ControlSoup/ContraHopper/Software/README.md

# Asoftware
Contains the Flightsoftware used on FlightBread

# Simulation
Basalisk framework simulation files
