ControlSoup/ContraHopper/Documentation/Structures/Motor Mount/Motor Mount.pdf

### 0.0.1 Motor Mount

The first component I decided to start with is interfacing the propeller to the duct. I started by making an assembly with the motors, and inner diameter of the duct floating in free space to get an image of what was required. After this I started thinking about how I could attach these motors. The typical process for me is to start with the most basic shape that meets the physical constraints , and then try and optimize for the failure mode of the part and manufacturability.

### 0.0.1.1 Geometrical Constraints

I started with a flat plate, however the bolt pattern of the motors does not allow the appropriate room for the hardware to be mounted sharing the same plate. This requires a spacer between the two motor mounts, that can allow for clearance of the m3 hex head, as well as integration and tooling (space to put the screw in, and space for an allen key). The length of the M3 screw, is going to be determined by my motor mount adapter thickness. Typically, there are mounted onto carbon fiber or injection molded plastic. For the motors I selected, most drone frames are about 4mm thick. There are some very good guides online on how to design FPV drone frames one is found here. (https://www.youtube.com/watch?v=C_gKnJ7wfto) Assuming an adapter plate of 4mm, I will be choosing a 8mm M3 bolt as my mounting hardware, this leaves 1.5mm sticking out past the motor mount flange. The total height of this bolt is 9.5mm. This gives me the following restrictions:

Distance Between Motor Mounts = M3 Length + 10% = 9.5mm + 10% = 10.45mm Clearance Circle for a M3 head = M3 Head = 5.5mm + 10% = 6.5mm

For the mounting arms, I will be using four cross members that go from the inner diameter of the duct meeting at the center. Three arms was my initial goal, however the bolt pattern did not allow for this. Here is a simplified model, that shows how the part meets each limiting criteria. The thickness of the cross members was kept at the same thickness as the motor mounts. This is to attempt to drive cost of manufacturing down, assuming this is made out of carbon fiber sheet.
Now that I have the most basic geometry for the structure. For analysis I’m going to assume the part is two fixed-fixed beams. For force, I am going to assume a point load based on the thrust of the two motors with zero efficiency loss to be conservative. Here are the results using the simply supported beam function in my Structures Engineering (https://github.com/ControlSoup/StructuresEngineering) repository.

P = Load
L = Length
A = CrossSectionalArea
Vmax = −1.433lbf

Mmax = 3.6722

lbf
in
σbending = 826.59psi

There are other stresses, that take place in this beam. This is not a complete analysis, but I will be stress testing the part to failure to see the true strength.

Images/Motor Mount/Motor Mount.PNG

Figure 1

### 0.0.1.2 Material and Cross Section Optimization

For each material I will iterate through the geometrical constraints, looking for a combinations that have a bending FOS greater than two. After that I will double check the deflection is very low, based on intuition, I want this beam to have a maximum deflection of no more than 0.02in.

Carbon Fiber

The material properties for Carbon fiber are notoriously hard to predict with out doing your own testing. This is made considerably harder by the fact that I don’t think a carbon fiber sheet on its side has the same material proprieties as a sheet in its nominal direction. This is probably negates my results, but I want to see what the hand calculations expect based on some conservative carbon fiber properties. AGATE

Images/simplysupported.png

Figure 2

CARBON PAPER ETD material properties are as follows:

Density = 1.35

g
cm³

= 0.0488

lb
in³
Ultimate Strength = 57.05ksi ElasticModulus = 6.77Msi

The optimization needs to be modified slightly. Carbon fiber sheets come in a select number of thickness, The thickness is what will determine my beam width. The following sizes where available I’ve included all the common options including 4mm found here. (https://protechcomposites.com/resources/standard-thicknesses) Additionally because our material properties are not very well known, and I am using the ultimate strength instead of yield, I will be optimizing to a FOS of 3 on the ultimate strength.

The results where as follows:

Cross Section W idth = 0.254mm Cross Section Height = 10.6mm σmax = 1.834pa

F OSbuckling = 4.5
Deflection = 0.498mm
W eight of Each Beam = 0.473g

Aluminum

Images/Buckling Optimizer_v1.png

Figure 3: Motor Mount Optimization Tree

The properties of aluminum are well know, 7075 T6 has the following properties:

Density = 0.102

lb
in³
Y ield Strength = 83ksi
ElasticModulus = 4.06Msi

The optimization will not need modification, a minimum thickness of 0.25mm was selected arbitrarily. I need a better model of failure to understand width limits.

The optimization results where as follows:

Cross Section W idth = 0.25mm Cross Section Height = 10.45mm σmax = 1.918pa
F OSbuckling = 5.52
Deflection = 0.344mm
W eight of Each Beam = 0.96g

3D Printed PLA

3d printing is a fantastic option for small scale prototyping like I am attempting here. Unfortunately, PLA acts extremely nonlinear under load. Again like carbon fiber, this most likely negates the results of my optimization. However, using some papers that can be found online I can attempt to get an initial guess at the strength of my part for initial design purposes.

The material properties where pulled from Paper1, and paper2 assuming 70% infill and are as follows:

Density = 0.0316

lb
in³
Y ield Strength = 2.5ksi
ElasticModulus = 0.123Msi

The optimization results where as follows:

Cross Section W idth = 1.06mm Cross Section Height = 25mm σmax = 0.079pa
F OSbuckling = 4.65
Deflection = 0.497mm
W eight of Each Beam = 3.033g

### 0.0.1.3 Final Selection and Conceptual Design

Based on these three materials, the optimal choice would be a carbon fiber sheet design. My optimization does not take into a account, torsional buckling, misalignment or the torque applied on the part by the motors when not spinning at the same speed. If I had access to some sort of FEA or analysis software I could be more confident in my design. However my confidence would still not be high due to the uncer-tainty in the material properties available online. I will need to rely on test results to be sure. Fabrication is a slight concern, I would probably go with several laser/CNC cut sheets that fit together using tabs, and then some kind of epoxy to fixture all of these together. This combination is workable, and could be an interesting choice. However, the cost is going to be higher, and making multiple to test to failure is out of my budget for this vehicle.

Aluminum, is an extremely good choice here, the material properties are extremely well known and the part is really not that heavy. Fabrication would be very difficult, this sheet would be extremely thin. Welding is not an option, some sort of epoxy might work but hardware is probably the best option.

PLA is going to be my choice, even though its the worst choice. The material properties are less reliable than carbon fiber, and it creates a substantially heavier piece. However, I am going to be relying on strength testing for all of these, due to my optimization being limited. 3d printing allows me to produce a lot of these parts break them, and modify until I am happy with the part. This also opens up the options of eliminating hardware, which at this scale could save enough weight to break even.

Here is final design, making modifications based on intuition, and rounding optimization results:

Images/mo/Final_Motor_Mount.PNG

Figure 4

The final hand calcs for failure are:

Cross Section W idth = 1.mm Cross Section Height = 25mm σmax = 0.083pa
F OSbuckling = 4.36
Deflection = 0.53mm
W eight of Each Beam = 2.87g

### 0.0.1.4 Testing Results and Changes

Images/Motor Mount/Motor Mount V1.PNG

Figure 5: Initial Print Mass

Initial print, gave me the idea to bring the actual mounting main mount down into the beams, this requires a larger minimum height for the column. Is defiantly strong enough, however deflection of off load axis is high. Suggest thickening sides in case of misalignment or torque. Struts are not available due to the space and print-ability. Notes about expected vs actual I ended up having to use 80% infill material properties have been adjusted also an error in my material properties was found:

ρ = 0.03612lb/∈

3Sy = 3306.86psiE = 203052.8psi

Force distribution if misalignment of thrust is 5◦

T hrust = 2600g
Fy = 2600g ∗ cos 5◦ = 226.6g Fx = 2600g ∗ sin 5◦ = 2590.1g

Based on this, one tenth of the expected thrust should be used as a side load (260g).

Deflection is my primary concern, however because the side load is in reality supported by another beam perpendicular to the one I am analyzing, I am willing to allow three times as much deflection (1.5mm) I will need to see in testing if this will work out.

Images/Motor Mount Optimization_V2png.png

Figure 6: Motor Mount Optimization Tree V2

Results of this optimization are:

Cross Section W idth = 2.638mm Cross Section Height = 18.45mm F OSvertical = 8.223
F OShorizontal = 11.756
Deflectionvertical = 0.303mm Deflectionhorizontal = 1.382 W eight of Each Beam = 6.335g

New Part Model:

Images/Motor Mount/Motor Mount V2.PNG

Figure 7

Test Results
