ControlSoup/ContraHopper/Documentation/Structures/Impact/Impact Investigation.pdf

## 1 Impact Duration

In order to determine an impact duration appropriate for landing, a series of test where preformed to estimate the impact time. Using a drone which is similar in size and mass (960g) to the ContraHopper, dropped from various heights repeatedly, a very rough estimate on two different parameters can be achieved. Its important to note that this is by no means an thorough and definitive answer to this question. The model is vastly over simplifying a complex interaction, results should be used indicate a ballpark including the parking-lot answer.

| Estimated Impact Time
| Validity of rigid body inelastic impact model

The impact model is based on rigid body kinematics, and a inelastic collision.

| Fl = ma
| a = ∆v
| ∆t
| ∆v = vl =

p
2gh
| ∆t =

√
2gh
a
| Fe = m

√
2gh
∆t

(1)

Fl = Landing Force

Fe = Estimated Landing Force

m = Mass of Vehicle

a = Deceleration on impact

∆t = Time of Impact

vl = Landing Velocity

g = Acceleration of Gravity

h = Distance Vehicle Falls

Some of the concerns I have about the results of this test are in the accuracy of the accelerometer measurements as well as the sample rate. Each test was repeated as many times as my neighbors would allow. The IMU being used is a mpu6050, with the following settings:

Log Rate = 200hz

Accelerometer Full scale Range = +-16g

Accelerometer Calibration Method = Post-Logging Mean Offset

Additionally, I am dropping the drone from marking on a tape measure by eye, there is likely an error in the height measurement.

## 2 Results


## 3 Notes

Unfortunately, this shows data that with the current configuration I will be unable to measure impact time, or loads. This does indicate that I should expect at least 4gs, more than that is unkown.

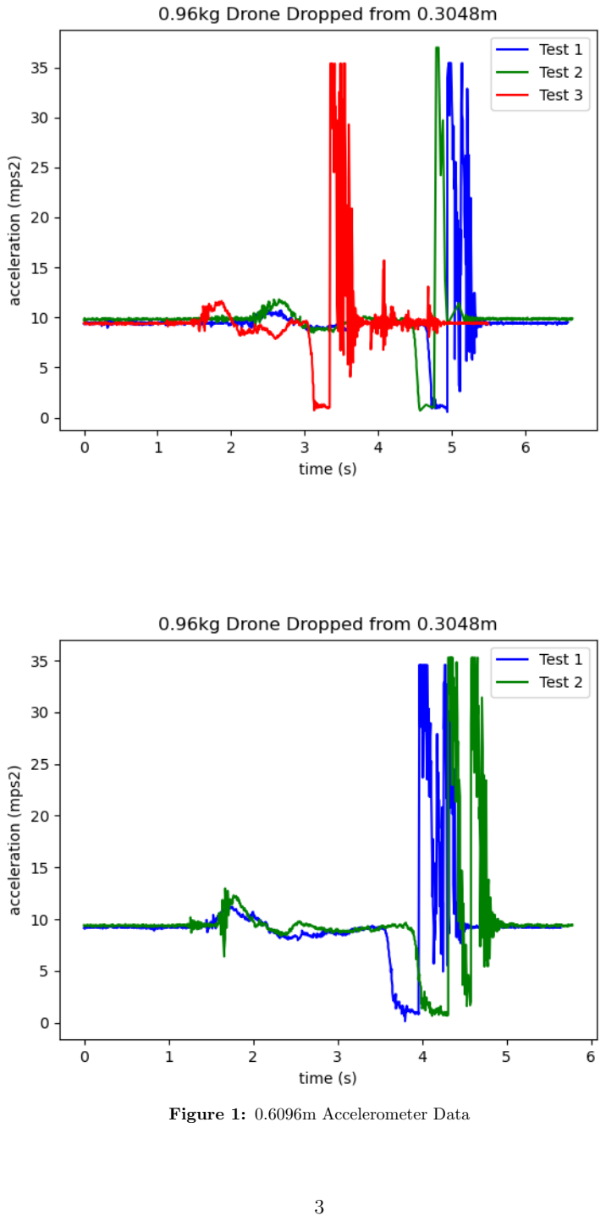
[picture p9: page 3]

Figure 1: 0.6096m Accelerometer Data
