ControlSoup/ContraHopper/Documentation/Structures/Landing Legs/Landing_Legs.pdf

### 0.0.1 Landing Gear

There are a couple different types of landing gear typically used on landers, shown bellow.


Based on research (Paper 1 (https://books.google.com/books?id=Pe4lEAAAQBAJ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) , Paper 2) (https://ltu.diva-portal.org/smash/get/diva2:1159285/FULLTEXT01.pdf) the tripod design offers the best specific strength and simpler analysis for small landers. This makes logical sense, as it is essentially just a truss. For this design no damping will be used.

The first question that needs answering to eventually get to the exact geometry of the landing gear, is how big does my landing radius need to be? The landing radius as I am defining it, is based on the circle that intersects each foot of the landing gear. The minimum effective tip-over radius is defined by the number of legs in this given landing radius. The more legs that are added, the closer the minimum effective tip-over radius comes to the landing radius. This is important in calculating your worst case tip over. The worst case tip over will exist about the axis defined by a line between any two neighboring legs around the

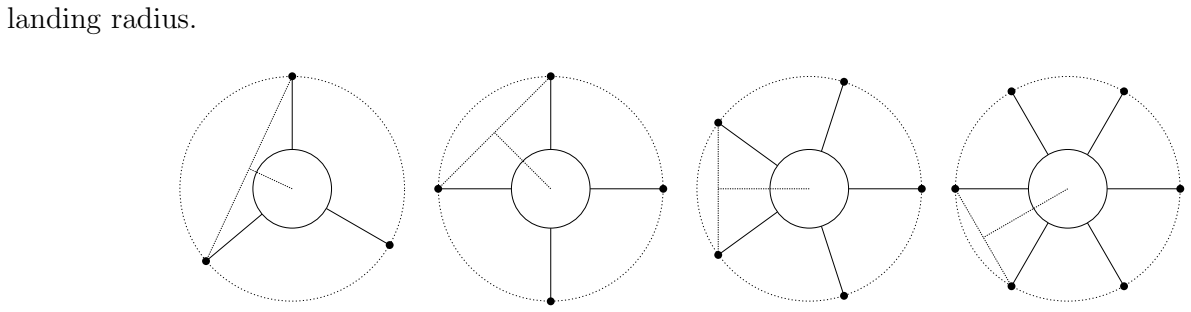
[picture p10: figure]
landing radius.

Four legs was chosen for this vehicle, due to motor mounts geometric constraints. This allows the landing legs to stay integrated, symmetric and a consistent with the rest of the vehicle frame.

Because landing is a complicated dynamic problem, I will be simplifying by choosing a large static tip over angle in the hopes that this results in a large enough effective landing radius, to compensate for the complex behavior. In order to design more carefully, I would need to estimate potential side forces, kinetic friction of the landing surface and run rigid body simulations to accurately access dynamic tip over. Instead , I have chosen a static tip over angle of 50◦
from horizontal. Because my landing gear is both symmetrical and square, I can also represent this in 2D without projecting a effective landing radius (this is not the case for different amounts of legs). This means that the minimum effective landing width (lw), must not exceed the value calculated value in Equation(1).

θ = Tip Over Angle

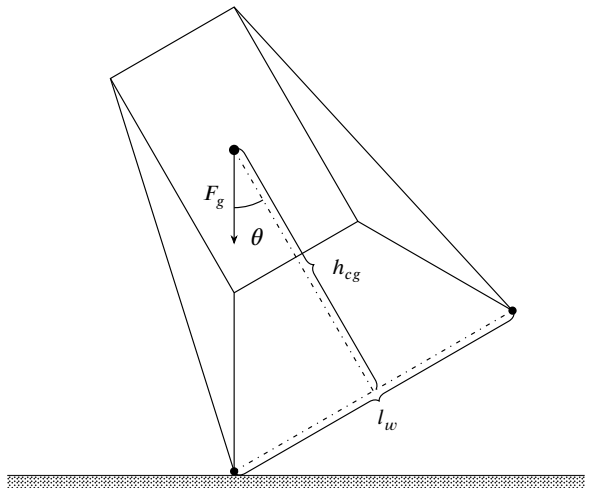
[picture p11: figure]
ℎcg

hcg = Height of the Center of Gravity

lw = Effective Landing Width

Fg = Force of Gravity

lw = 2hcg sin θ | (1)

The height of the center of gravity with respect to the landing gear, is equal to the current height of the structure of the vehicle, plus a chosen two and a half inches of ground clearance. After the major mass components had finished design, this height came out to 8.947in.

lw = 2 ∗ 8.947in ∗ sin 50◦

lw = 13.7in

From this, using the derived sketch of the vehicle, the ground clearance and effective landing radius can be defined to generate the base coordinates of the landing gear truss members.

Estimated landing forces, as I have found is extremely difficult without building something, simulating something or using expensive analysis software. Originally, I was going to use a hand calculation based on the assumption of a inelastic collision with the ground. Unfortunately, this requires a major assumption about the time duration of the impact. Resources online vary wildly for how long an impact takes to decelerate a body, a difference of a couple milliseconds can vary the load by a factor of more than 100. I attempted to measure impact accelerations and estimate this time, using a drone dropped from various heights however the mems accelerometer that I am using even at its max full scale range of +-16gs, provided saturated and untrustworthy data of around 4gs. For this reason I will be adding a conservative fudge factor of 2 onto that measure figure (8gs). This is not accurate is simply a judgment call, for the purposes of future vehicle designs. I will be building a dedicated test stand to measure impact loads on landing. I will adjust the landing leg design once I have a better idea what these loads are.

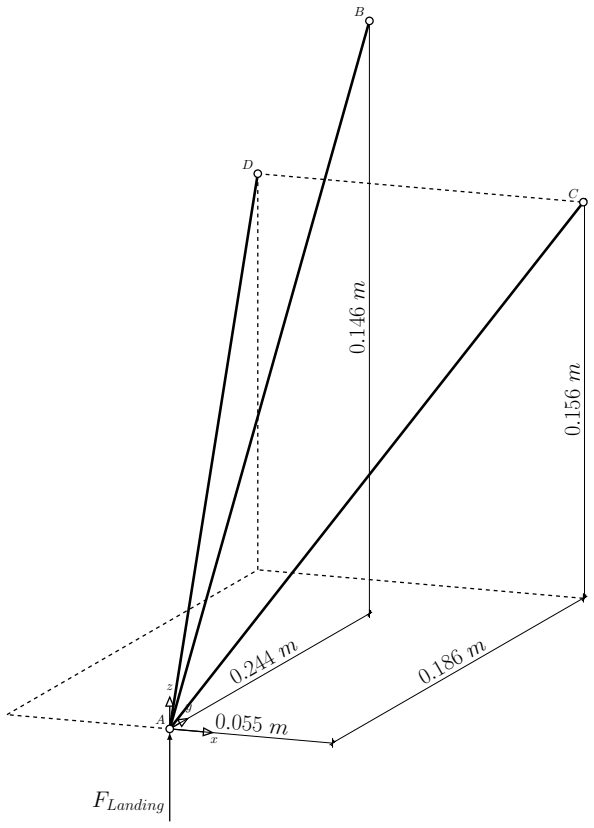
[picture p12: figure]
FLanding

Figure 1: Landing Leg Truss

Using the current estimated mass of the vehicle without landing legs (an assumption that needs to be considered for the FOS later, landing gear may increase the vehicle mass by 10%) of 591.58g, the following landing load on the vehicle was calculated:

Fl = 8g mv = 8 ∗ 9.8055

m
s

2

∗ 0.59158kg = 46.4N

Now that the landing load is known, the problem is statically determinate and requires only analysis at the foot joint.

A

Fl
4

Fc

Ft1

Ft2

Vector Components:

Fl
4

[0i + 0j + 1k]

Fc [0i + 0.51282263j + 0.85849458k]

Ft1

[0.22127908i + 0.74661525j + 0.62737647k]

Ft2 = F2 [-0.2212790i + 0.74661525j + 0.62737647k]

Assuming all members are in tension (despite the intuition shown in the FBD) the following static equations can be derived:

ΣFi = Ft1

i − Ft1

i = 0
ΣFj = Fcj + 2 Ft1

j = 0

ΣFk =

Fl
4

k + Fck + 2Ft1 k = 0

(2)

Supplementing the design figure of landing force and simplifying:

Fl
4

k = 11.6N

0.512 Fc + 1.493 Ft1 | = 0
0.858 Fc + 1.254 Ft1 | = −11.6N

Solving the system of equations:

Fc = −27.15N
Ft1 = Ft2 = 9.32N

Negative values indicate the member is in compression. Its important to note at this point that the actual assembly is not the ideal truss, there are slight eccentric loads and the members will not be in perfect axial loading conditions as assumed in this model. For this reason I will be using higher FOS than usual. Additionally, the initial results of this optimization showed cross sections that where very small in the tension. This small cross section made me concerned about deflection, this has been added to the optimization. Deflection was not a consideration for the compression members.

Now that the loads have been established, an optimization for the minimum weight member given a cir-cular cross section can be preformed based on the following design factors.

Compression Member:

Failure Mode = Buckling

Target Factor of Safety on Ultimate = 4

Tension Members:

Failure Mode = Tensile

Target Factor of Safety on Ultimate = 2.5

Target Displacement = 0.0025m

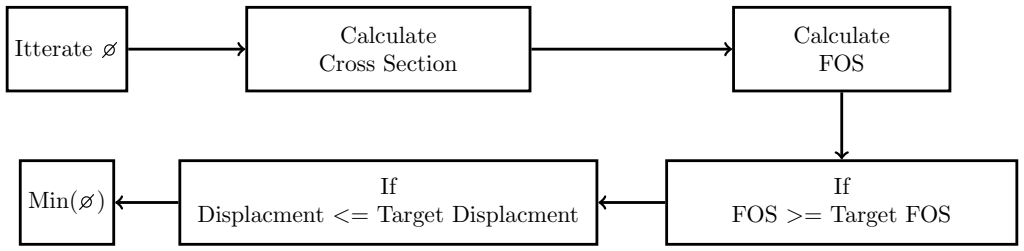
[picture p13: figure]
Itterate ; Calculate Cross Section; Calculate FOS; If FOS >= Target FOS

Displacment <= Target Displacment Min()

The material trade was not in depth for this part, carbon fiber seemed to be the logical choice for both integration and mass.

Results:

Compression Member:

Diameter = 0.003358m

Factor of Safety = 4

Tension Members:

Diameter = 0.00029m

Factor of Safety = 11.3

Displacement = 0.0025m

Based on the available carbon rods the final size choice is:

Compression Member Diameter = 3.45mm (0.136in)

Tension Member’s Diameter = 0.5mm (0.020in)


Design as of 09/10/22
