ControlSoup/ContraHopper/Documentation/Structures/Landing Legs/Landing_Legs_Fig/FBD_point_A.pdf

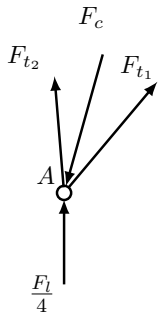
[picture p14: figure]
