ControlSoup/ContraHopper/Documentation/Structures/Landing Legs/Landing_Legs_Fig/Landing_Leg_Optimization_Logic.pdf

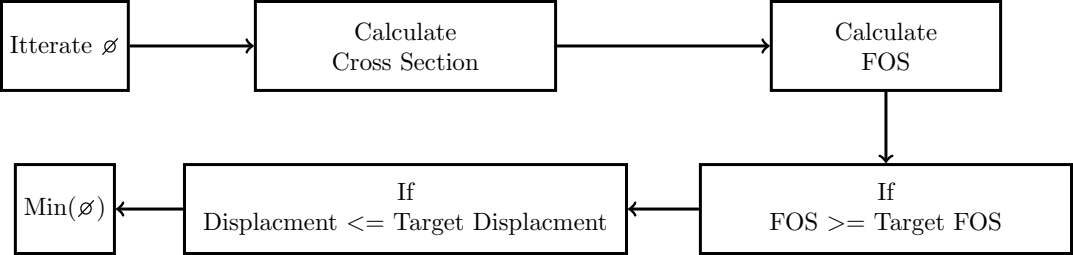
[picture p15: figure]
Itterate ; Calculate Cross Section; Calculate FOS; If FOS >= Target FOS

Displacment <= Target Displacment Min()
