ControlSoup/ContraHopper/Documentation/Structures/Landing Legs/Landing_Legs_Fig/Landing_Radius.pdf

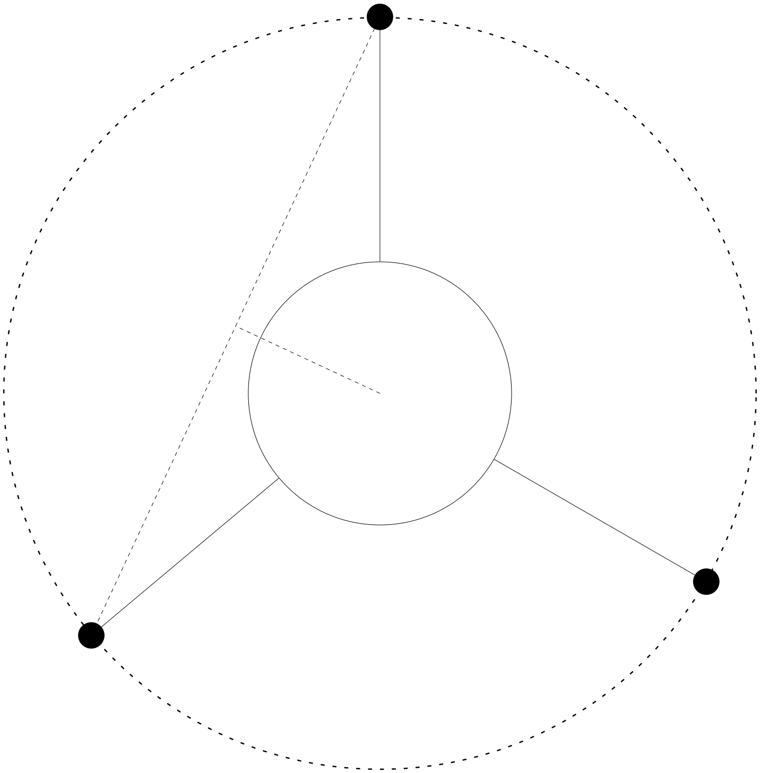
[picture p16: figure]
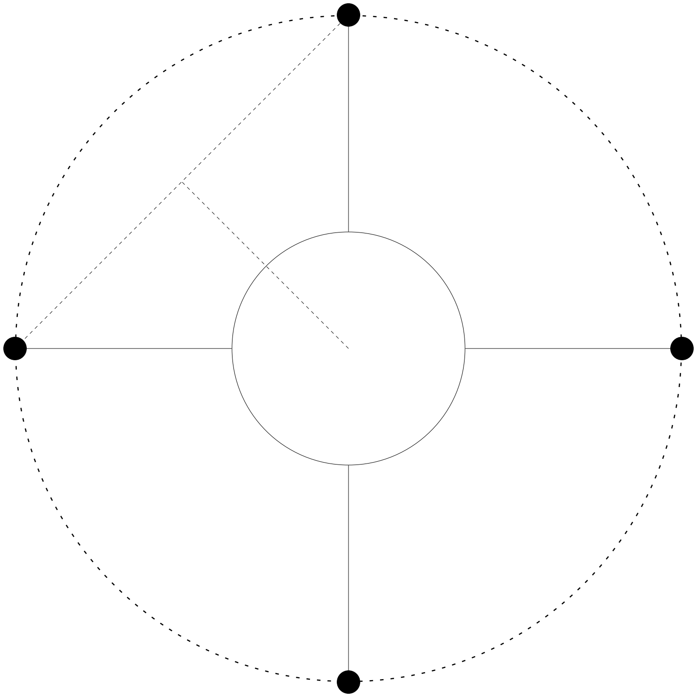
[picture p17: figure]
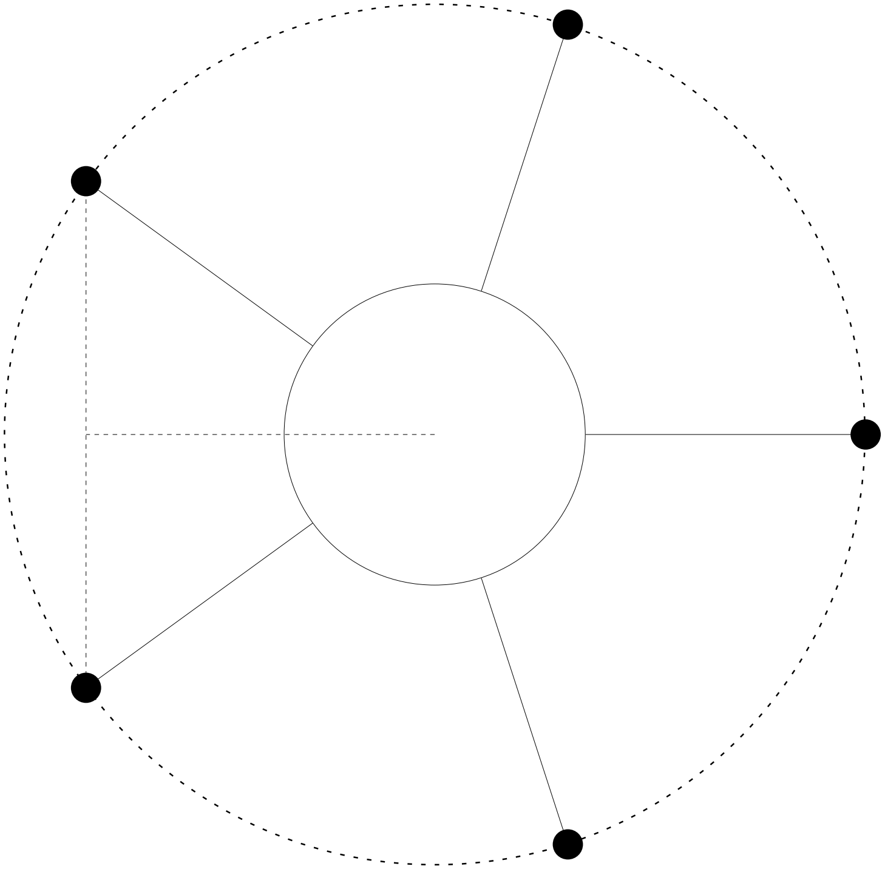
[picture p18: figure]
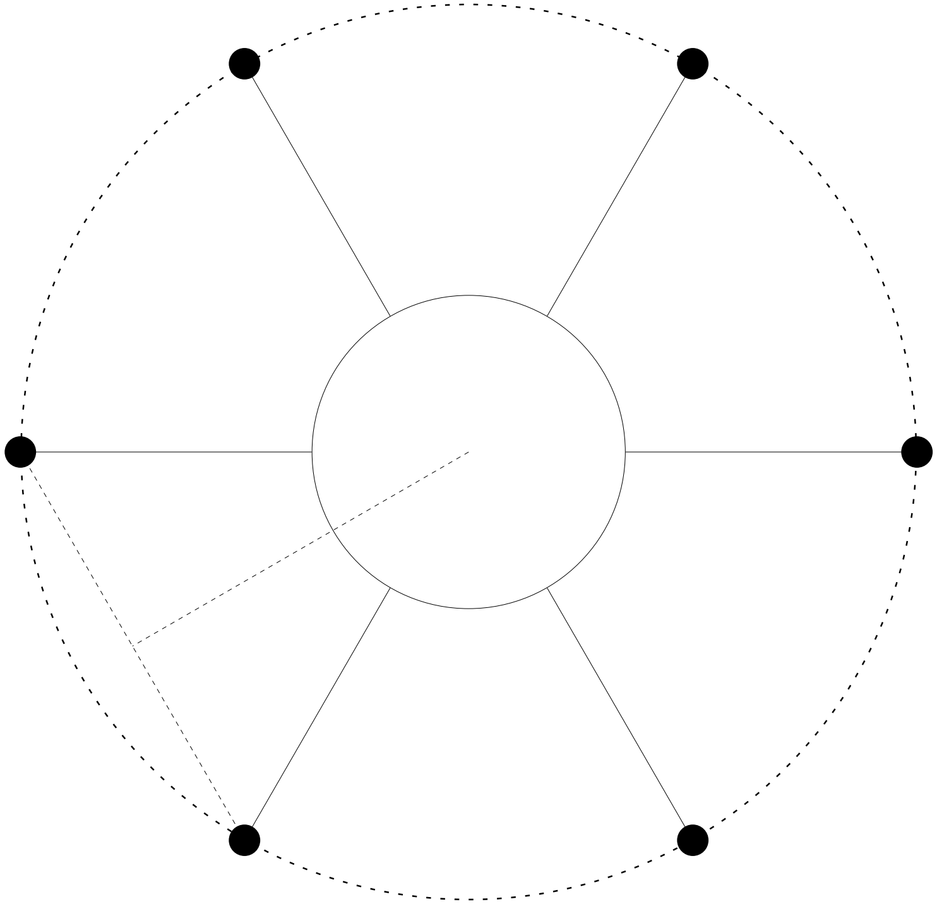
[picture p19: figure]
