ControlSoup/ContraHopper/Documentation/Structures/Landing Legs/Landing_Legs_Fig/Tip_Over.pdf

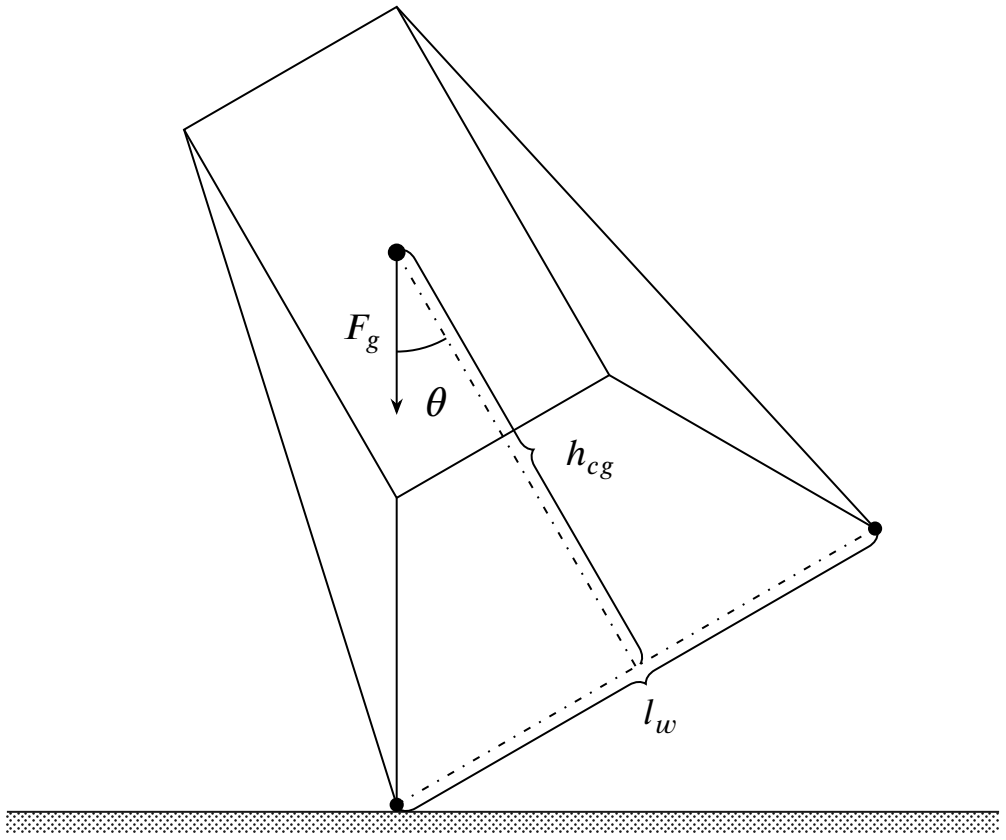
[picture p20: figure]
ℎcg
