ControlSoup/ContraHopper/Documentation/Structures/Vehicle Frame/Vehicle_Frame_Fig/Deriving Sketch 2.PNG

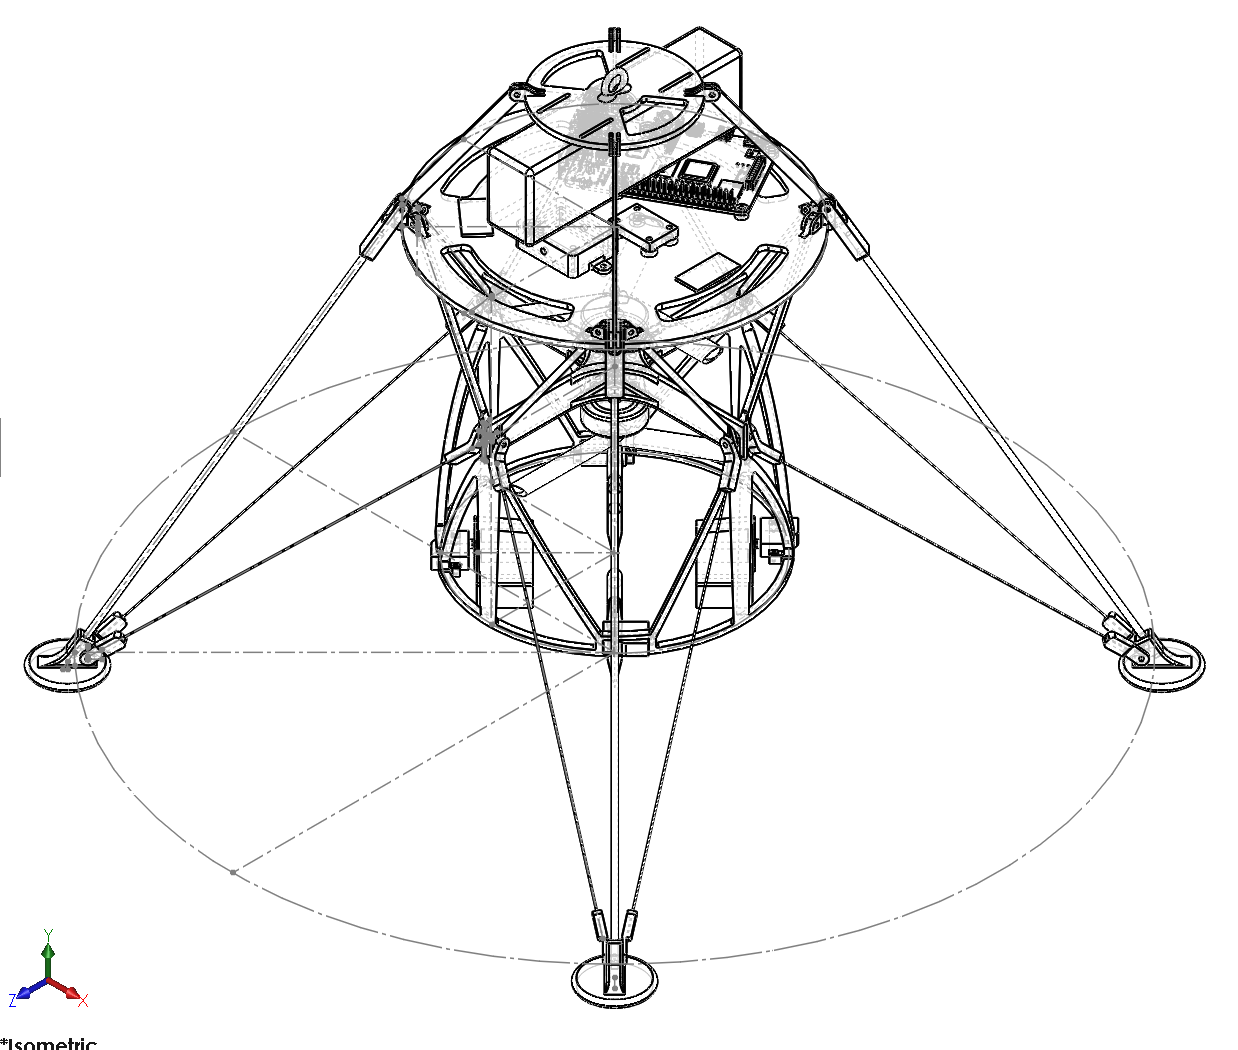
Documentation/Structures/Vehicle Frame/Vehicle_Frame_Fig/Deriving Sketch 2.PNG
