ControlSoup/ContraHopper/Documentation/Structures/Vehicle Frame/Vehicle_Frame_Fig/Deriving Sketch.PNG

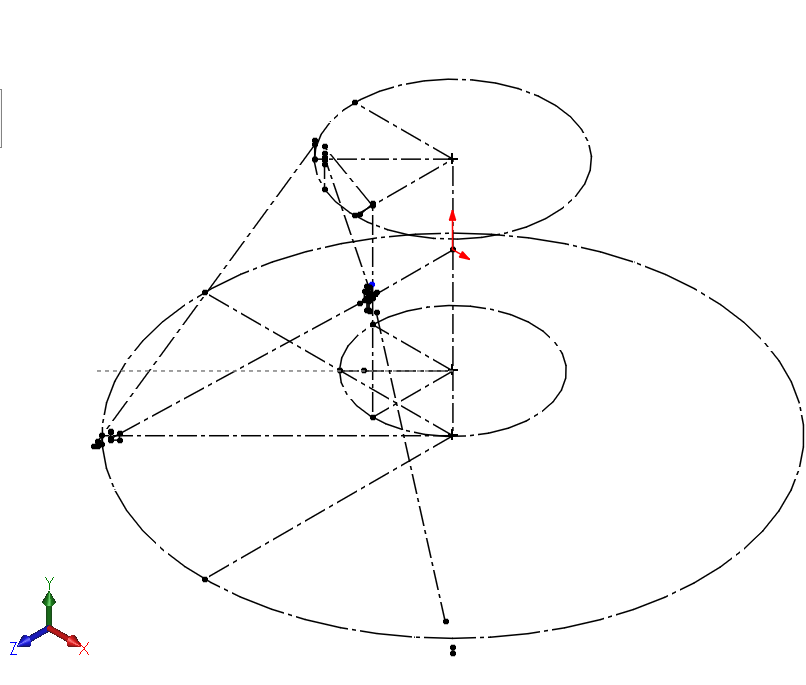
Documentation/Structures/Vehicle Frame/Vehicle_Frame_Fig/Deriving Sketch.PNG
