ControlSoup/ContraHopper/Avionics/PCB/FlightBread_0.1.step

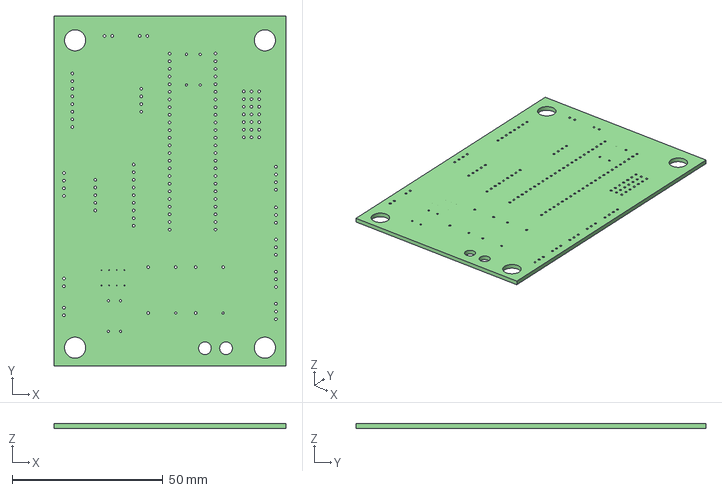
[picture p23: CAD file, 2023-03-12]
Avionics/PCB/FlightBread_0.1.step
77.0 x 116.0 x 1.60 mm
