ControlSoup/ContraHopper/Tests/Impact Test/1ft_test_1.txt

test_number,time(s),ax(ms2),ay(ms2),az(ms2),gx(deg/s),gy(deg/s),gz(deg/s)
1,0.01,1.35,-0.35,8.87,0.01,-0.23,-0.19
1,0.02,1.39,-0.34,8.94,-0.09,-0.09,-0.02
1,0.02,1.33,-0.33,8.95,0.13,-0.08,-0.02
1,0.03,1.3,-0.34,8.9,-0.05,0.05,-0.16
1,0.03,1.33,-0.35,8.97,-0.06,0.09,0.05
1,0.04,1.22,-0.36,8.84,-0.09,0.12,0.02
1,0.04,1.29,-0.32,8.96,-0.16,0.08,-0.07
1,0.04,1.31,-0.32,9,0,-0.15,-0.15
1,0.05,1.33,-0.36,9,0.03,0.15,-0.12
1,0.06,1.25,-0.34,8.88,-0.02,0,-0.16
1,0.06,1.38,-0.32,9.02,0.06,-0.02,-0.04
1,0.06,1.28,-0.37,8.94,-0.05,0,-0.3
1,0.07,1.4,-0.32,8.92,0.07,-0.29,-0.19
1,0.08,1.25,-0.35,8.92,-0.02,-0.03,-0.04
1,0.08,1.37,-0.3,8.93,0.12,0,-0.27
1,0.08,1.22,-0.35,8.98,0.17,0.02,-0.24
1,0.09,1.38,-0.27,8.87,-0.09,-0.02,0
1,0.1,1.25,-0.3,8.85,0.1,-0.11,-0.13
1,0.1,1.39,-0.38,8.93,-0.02,0.09,0.05
1,0.1,1.23,-0.35,9.01,0.04,0.09,-0.12
1,0.11,1.36,-0.26,8.95,0.01,-0.02,-0.33
1,0.12,1.22,-0.44,8.85,-0.06,-0.02,-0.15
1,0.12,1.32,-0.29,8.98,0.03,0.11,0
1,0.12,1.28,-0.36,8.9,-0.03,0,-0.24
1,0.13,1.26,-0.3,8.92,0.1,0.05,-0.19
1,0.14,1.33,-0.28,8.89,0.03,0.09,-0.13
1,0.14,1.29,-0.36,8.83,0.04,-0.06,-0.15
1,0.15,1.38,-0.32,8.89,0.07,-0.17,-0.24
1,0.15,1.27,-0.34,8.91,0.04,0,-0.34
1,0.16,1.28,-0.32,8.95,-0.06,-0.2,-0.13
1,0.16,1.4,-0.3,9.02,-0.23,0.18,-0.18
1,0.17,1.25,-0.34,8.91,-0.03,0.09,0
1,0.17,1.39,-0.34,9.01,-0.06,0.08,-0.08
1,0.17,1.21,-0.32,8.97,-0.22,0.03,-0.13
1,0.18,1.4,-0.33,8.98,0.07,0,0
1,0.19,1.32,-0.3,8.88,-0.14,0.05,-0.19
1,0.19,1.32,-0.32,8.89,0.07,0.06,0.04
1,0.19,1.26,-0.38,8.95,0.12,0.02,-0.05
1,0.2,1.33,-0.32,8.97,-0.03,0.08,0.05
1,0.2,1.32,-0.34,8.96,0.07,-0.06,-0.05
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
