ControlSoup/ContraHopper/Tests/Impact Test/1ft_test_3.txt

test_number,time(s),ax(ms2),ay(ms2),az(ms2),gx(deg/s),gy(deg/s),gz(deg/s)
3,35.57,1.25,-0.26,8.97,0.04,0.03,-0.05
3,35.58,1.36,-0.28,8.88,0.03,-0.13,0.06
3,35.58,1.23,-0.28,8.85,-0.06,0.09,0.11
3,35.59,1.36,-0.29,8.97,-0.08,-0.1,-0.05
3,35.59,1.31,-0.29,8.91,-0.17,-0.06,-0.09
3,35.6,1.23,-0.35,9.06,0.06,0.09,0.14
3,35.6,1.39,-0.33,8.88,0.14,-0.05,0.14
3,35.61,1.28,-0.32,8.91,0.01,-0.1,0.17
3,35.61,1.38,-0.32,8.88,0.01,-0.05,-0.08
3,35.62,1.24,-0.36,8.9,0.15,0.07,-0.05
3,35.62,1.36,-0.3,8.92,-0.08,-0.14,0.06
3,35.63,1.3,-0.28,8.93,0.01,0,-0.06
3,35.63,1.32,-0.3,8.84,-0.08,-0.23,0.14
3,35.64,1.25,-0.28,8.9,0.01,-0.14,0.08
3,35.65,1.35,-0.29,8.92,0.03,0.03,0.06
3,35.65,1.34,-0.37,8.83,0.15,-0.03,-0.03
3,35.65,1.29,-0.29,8.87,0.03,0.07,-0.05
3,35.66,1.37,-0.33,8.94,0.14,-0.06,-0.14
3,35.67,1.31,-0.31,8.99,-0.08,-0.05,-0.05
3,35.67,1.26,-0.29,8.88,-0.18,0.03,0.14
3,35.68,1.31,-0.31,8.87,0,-0.03,0.08
3,35.68,1.33,-0.33,8.85,-0.03,0.26,0.27
3,35.69,1.28,-0.37,8.91,0.01,-0.03,0
3,35.69,1.32,-0.32,8.86,0.12,-0.16,-0.08
3,35.7,1.36,-0.32,8.95,-0.11,0.1,0.01
3,35.7,1.26,-0.32,8.94,-0.18,0.04,0
3,35.71,1.35,-0.36,8.87,-0.08,-0.17,0.06
3,35.71,1.3,-0.27,8.99,0.21,0.01,0.05
3,35.72,1.39,-0.33,8.89,-0.05,-0.11,0.06
3,35.72,1.32,-0.29,8.85,-0.17,-0.13,-0.06
3,35.73,1.29,-0.38,8.95,-0.09,0,-0.08
3,35.73,1.35,-0.31,8.9,-0.06,0.04,0.03
3,35.74,1.32,-0.34,8.87,0.27,0.03,0.05
3,35.74,1.39,-0.29,8.95,-0.12,0.01,-0.02
3,35.75,1.22,-0.39,8.95,-0.08,0.16,-0.08
3,35.75,1.39,-0.29,8.9,0.03,-0.2,-0.06
3,35.76,1.32,-0.35,8.92,-0.22,-0.16,-0.06
3,35.76,1.39,-0.33,8.88,0.12,-0.13,-0.03
3,35.77,1.25,-0.33,8.87,0.14,-0.11,0.01
3,35.77,1.33,-0.26,8.95,0,0.1,0.03
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
