ControlSoup/ContraHopper/Tests/Impact Test/2ft_test_1.txt

test_number,time(s),ax(ms2),ay(ms2),az(ms2),gx(deg/s),gy(deg/s),gz(deg/s)
1,0.01,1.19,-0.34,8.89,0.02,0.05,-0.03
1,0.02,1.41,-0.34,8.8,-0.01,0,0.06
1,0.02,1.25,-0.4,8.87,0.14,-0.15,-0.03
1,0.03,1.39,-0.31,8.89,-0.08,-0.1,-0.07
1,0.03,1.27,-0.34,8.94,0.09,-0.07,-0.13
1,0.04,1.43,-0.31,8.95,0.18,0.13,-0.16
1,0.04,1.29,-0.35,8.95,0.03,-0.13,-0.16
1,0.05,1.36,-0.33,8.87,-0.01,-0.04,0.02
1,0.05,1.28,-0.33,8.91,0.15,-0.13,0.06
1,0.06,1.36,-0.37,9,-0.01,-0.07,-0.13
1,0.06,1.31,-0.37,8.9,-0.01,0,-0.13
1,0.07,1.35,-0.35,8.92,0.15,-0.04,-0.01
1,0.07,1.25,-0.37,8.93,0.05,-0.25,-0.1
1,0.08,1.3,-0.37,8.89,-0.12,-0.05,0.06
1,0.08,1.3,-0.36,9.02,0.23,-0.1,0.08
1,0.09,1.35,-0.33,8.98,-0.05,-0.02,0.05
1,0.09,1.26,-0.37,8.97,0.02,-0.19,-0.12
1,0.1,1.3,-0.36,8.95,-0.03,-0.15,-0.03
1,0.1,1.3,-0.34,8.96,0.12,-0.05,-0.04
1,0.11,1.27,-0.42,8.92,0.09,-0.13,-0.04
1,0.11,1.33,-0.37,9.04,-0.03,-0.11,0.08
1,0.12,1.28,-0.36,8.97,0.03,-0.08,0.03
1,0.12,1.3,-0.29,9.03,-0.09,-0.22,-0.13
1,0.13,1.23,-0.32,8.94,-0.11,0,-0.06
1,0.13,1.33,-0.33,8.91,0.06,-0.07,-0.03
1,0.14,1.33,-0.35,8.94,0.02,-0.11,-0.06
1,0.14,1.35,-0.3,9,0.12,-0.18,-0.03
1,0.15,1.32,-0.35,9,-0.08,-0.1,0.09
1,0.16,1.38,-0.27,8.94,0.02,-0.05,0.02
1,0.16,1.21,-0.38,8.92,0.06,-0.08,0.03
1,0.17,1.39,-0.3,8.91,-0.01,0,-0.15
1,0.17,1.29,-0.36,8.9,-0.14,-0.21,-0.03
1,0.17,1.37,-0.34,8.95,0.02,-0.07,0.05
1,0.18,1.27,-0.35,8.95,-0.01,-0.18,0.09
1,0.19,1.3,-0.35,8.95,0,-0.21,-0.03
1,0.19,1.27,-0.35,8.94,0.11,-0.07,0.09
1,0.19,1.43,-0.39,9,-0.06,-0.16,0.05
1,0.2,1.24,-0.36,8.87,-0.12,0,-0.09
1,0.2,1.33,-0.34,8.97,-0.01,0,-0.07
1,0.21,1.29,-0.37,8.9,-0.11,-0.08,0.08
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
