ControlSoup/ContraHopper/Documentation/Structures/Landing Legs/Landing_Legs_Fig/Landing_Leg_Truss.pdf

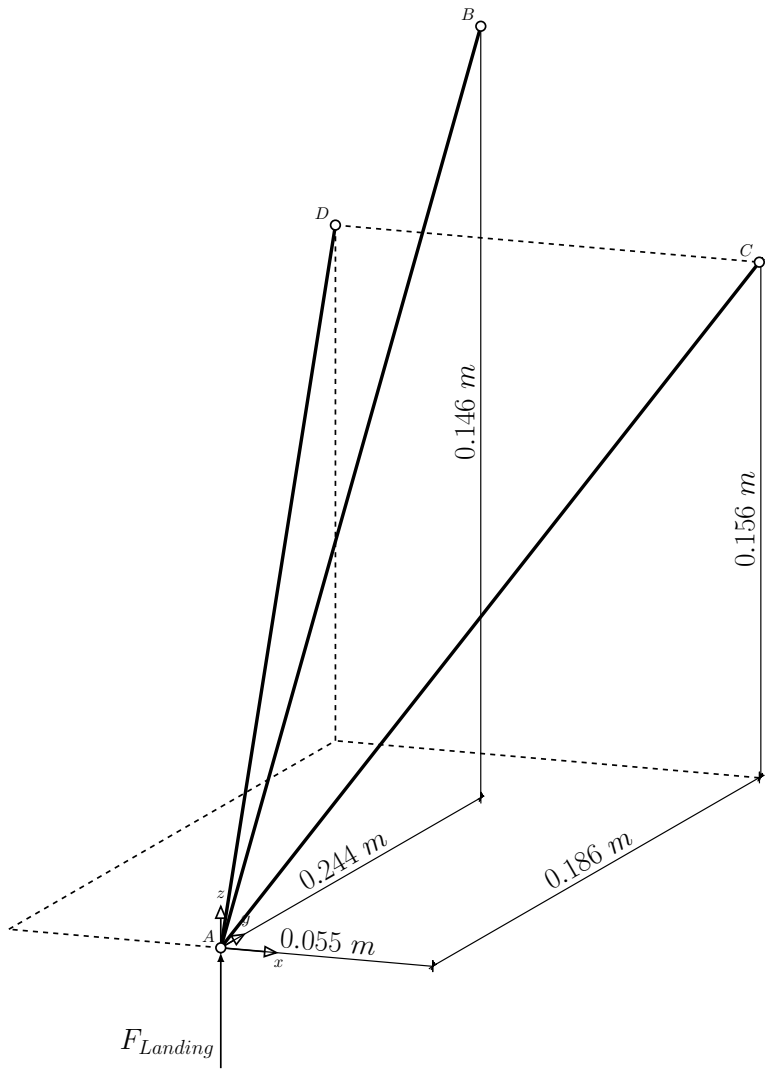
[picture p24: page 1]
FLanding
