ControlSoup/ContraHopper/Documentation/Structures/Vehicle Frame/Vehicle_Frame_Fig/Tether_Truss.pdf

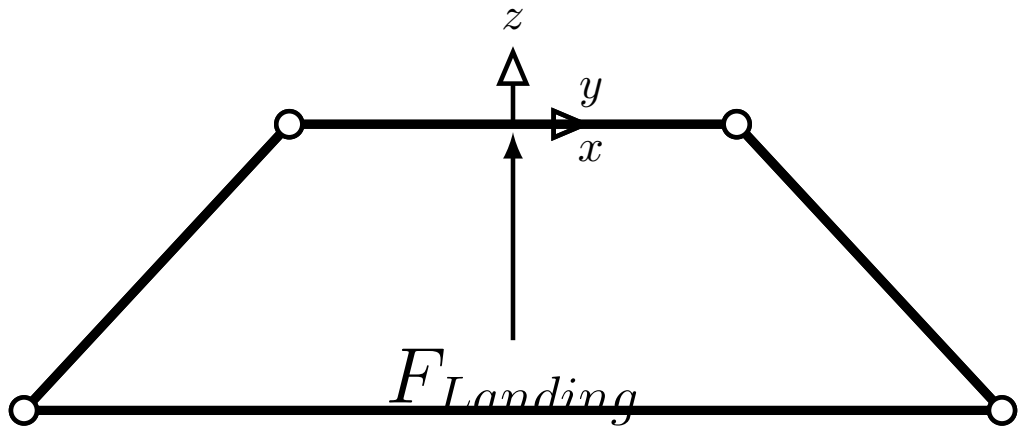
[picture p25: page 1]
FLanding
