ControlSoup/ContraHopper/Avionics/FlightBread/FlightBread.kicad_pcb

## KiCad design Avionics/FlightBread/FlightBread.kicad_pcb (2023-03-12)

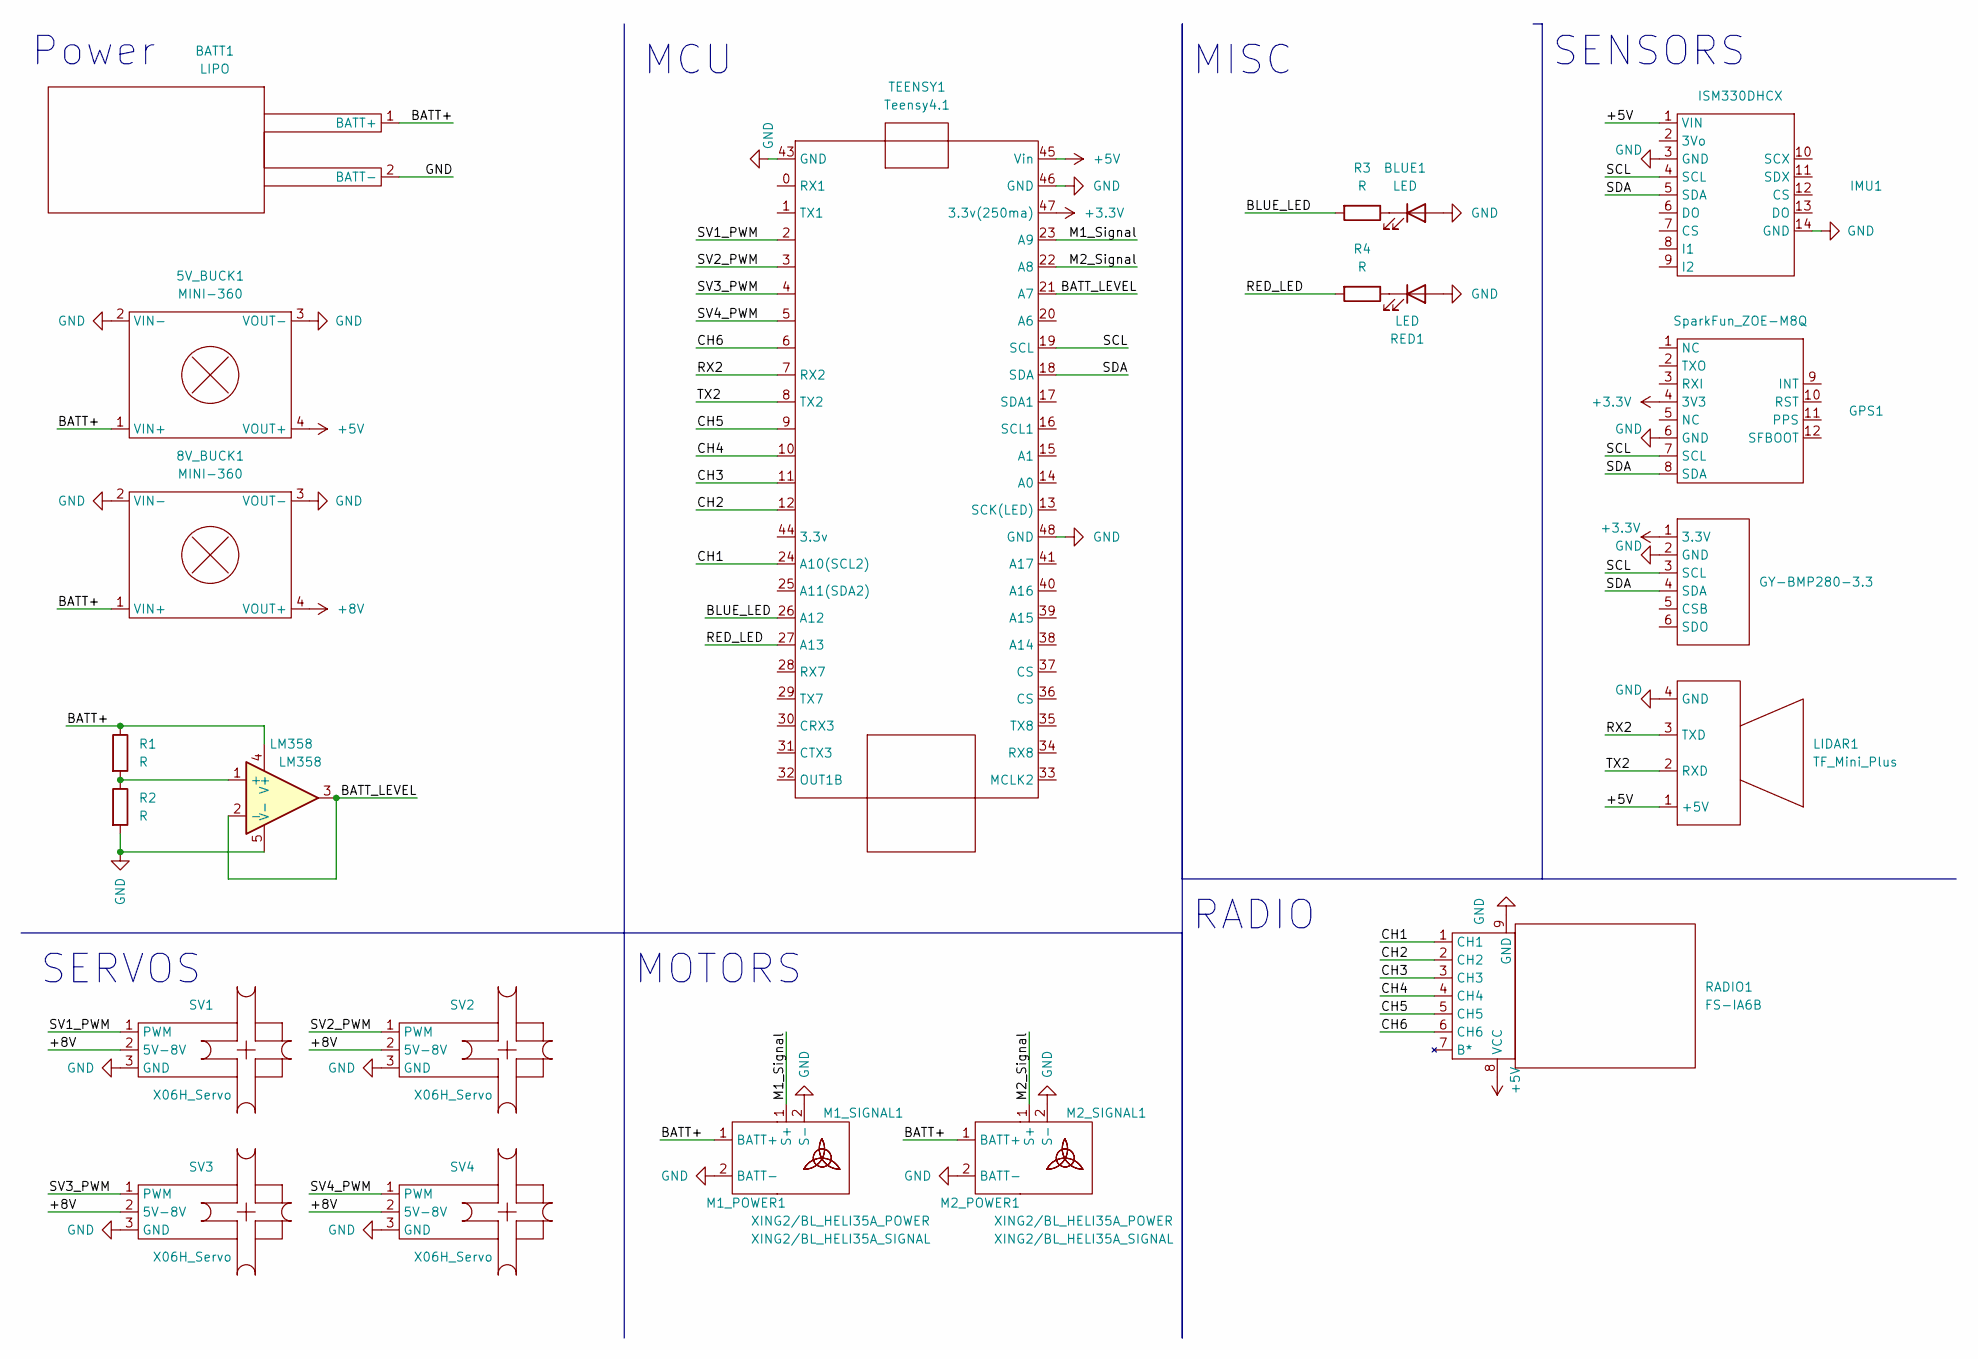
[picture p26: schematic FlightBread.kicad_sch]

Parts:
5V_BUCK1, 8V_BUCK1: MINI-360; MINI_360
BARO1: GY-BMP280-3.3; JST_XH_4pin
BATT1: LIPO; XT60_MOUNT
BLUE1: LED
GPS1: SparkFun_ZOE-M8Q; SparkFun_ZOEM8Q
IMU1: ISM330DHCX
LIDAR1: TF_Mini_Plus; JST_XH_4pin
LM358: LM358
M1_POWER1, M2_POWER1: XING2/BL_HELI35A_POWER; ESC_POWER
M1_SIGNAL1, M2_SIGNAL1: XING2/BL_HELI35A_SIGNAL; JST_XH_2pin
R1, R2, R3, R4: R; pinhole_resistor
RADIO1: FS-IA6B
RED1: LED
SV1, SV2, SV3, SV4: X06H_Servo; JST_XH_3pin
TEENSY1: Teensy4.1

Connections:
+3.3V: BARO1.1 (3.3V), GPS1.4 (3V3), TEENSY1.47 (3.3v(250ma))
+5V: 5V_BUCK1.4 (VOUT+), IMU1.1 (VIN), LIDAR1.1 (+5V), RADIO1.8 (VCC), TEENSY1.45 (Vin)
+8V: 8V_BUCK1.4 (VOUT+), SV1.2 (5V-8V), SV2.2 (5V-8V), SV3.2 (5V-8V), SV4.2 (5V-8V)
/BATT+: 5V_BUCK1.1 (VIN+), 8V_BUCK1.1 (VIN+), BATT1.1 (BATT+), LM358.4 (V+), M1_POWER1.1 (BATT+), M2_POWER1.1 (BATT+), R1.1
/BATT_LEVEL: LM358.2 (-), LM358.3, TEENSY1.21 (A7)
/BLUE_LED: R3.2, TEENSY1.26 (A12)
/CH1: RADIO1.1 (CH1), TEENSY1.24 (A10(SCL2))
/CH2: RADIO1.2 (CH2), TEENSY1.12
/CH3: RADIO1.3 (CH3), TEENSY1.11
/CH4: RADIO1.4 (CH4), TEENSY1.10
/CH5: RADIO1.5 (CH5), TEENSY1.9
/CH6: RADIO1.6 (CH6), TEENSY1.6
/M1_Signal: M1_SIGNAL1.1 (S+), TEENSY1.23 (A9)
/M2_Signal: M2_SIGNAL1.1 (S+), TEENSY1.22 (A8)
/RED_LED: R4.2, TEENSY1.27 (A13)
/RX2: LIDAR1.3 (TXD), TEENSY1.7 (RX2)
/SCL: BARO1.3 (SCL), GPS1.7 (SCL), IMU1.4 (SCL), TEENSY1.19 (SCL)
/SDA: BARO1.4 (SDA), GPS1.8 (SDA), IMU1.5 (SDA), TEENSY1.18 (SDA)
/SV1_PWM: SV1.1 (PWM), TEENSY1.2
/SV2_PWM: SV2.1 (PWM), TEENSY1.3
/SV3_PWM: SV3.1 (PWM), TEENSY1.4
/SV4_PWM: SV4.1 (PWM), TEENSY1.5
/TX2: LIDAR1.2 (RXD), TEENSY1.8 (TX2)
GND: 5V_BUCK1.2 (VIN-), 5V_BUCK1.3 (VOUT-), 8V_BUCK1.2 (VIN-), 8V_BUCK1.3 (VOUT-), BARO1.2 (GND), BATT1.2 (BATT-), BLUE1.2 (A), GPS1.6 (GND), IMU1.3 (GND), IMU1.14 (GND), LIDAR1.4 (GND), LM358.5 (V-), M1_POWER1.2 (BATT-), M1_SIGNAL1.2 (S-), M2_POWER1.2 (BATT-), M2_SIGNAL1.2 (S-), R2.2, RADIO1.9 (GND), RED1.2 (A), SV1.3 (GND), SV2.3 (GND), SV3.3 (GND), SV4.3 (GND), TEENSY1.43 (GND), TEENSY1.46 (GND), TEENSY1.48 (GND)
unnamed: LM358.1 (+), R1.2, R2.1
unnamed: BLUE1.1 (K), R3.1
unnamed: R4.1, RED1.1 (K)

Notes on the sheet:
Power
MOTORS
RADIO
MISC
SERVOS
SENSORS
MCU

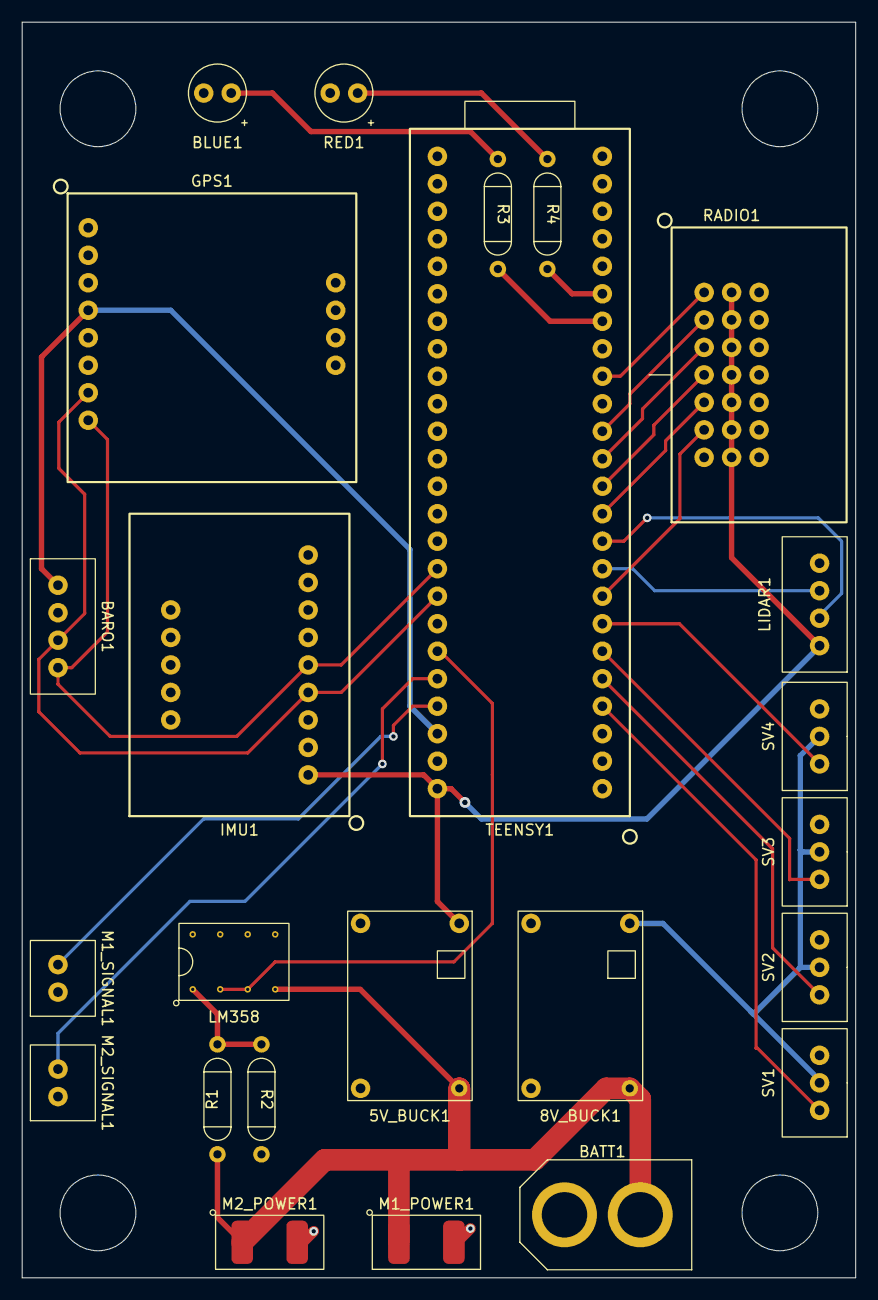
[picture p27: board FlightBread.kicad_pcb from above]

Board: 2 copper layers, 77.0 x 116.0 mm, 24 parts (0 on the bottom side), 27 nets.
