ControlSoup/ContraHopper/(commit log)

2022-06-24 3rd case still no match
2022-09-11 Master Document, and Landing Leg Completion
2022-09-19 Ready for First Print
    Added some functions to SEF and finished the Tether Truss portion of the Contra Doc
2022-11-25 switches to Teensy 4.1, and updating documentation
2022-12-18 switching over to a C version of the simulation
2022-12-18 switched to C for the simulation
2022-12-28 Renamed state_vector to state_matrix, added work to Sensors class
2022-12-28 started work on the software sim, currently have not been able to pass a 1d vector back to python
2022-12-29 switched to a vector format instead of a matrix format, confirmed passing a vector to a C functinos owkrs
2023-01-02 velocity was not corrected for the body frame
2023-01-08 updated sensor model
2023-01-08 first pass at a sensor_model
2023-01-08 first pass a sensor model (kinda sketchy)
2023-01-22 switched over to a basilisk simulation, implemented plotting ect
2023-01-22 test external force torque functionality
2023-01-30 update for kidcad
    [ContraHopperFlightComputer.kicad_pcb, ContraHopperFlightComputer.kicad_sch]
2023-01-30 updated kicad files
2023-01-30 kicad fully integrated with git hub
    [ContraHopperFlightComputer.kicad_pcb, ContraHopperFlightComputer.kicad_sch]
2023-02-25 flight bread and more
    [FlightBread.kicad_pcb, FlightBread.kicad_sch]
2023-02-26 first board print, rushed but I wanna get somthing to start writing the code.....
    [FlightBread-B_Cu.gbl, FlightBread-B_Mask.gbs, FlightBread-B_Paste.gbp, FlightBread-B_Silkscreen.gbo, FlightBread-Edge_Cuts.gm1, FlightBread-F_Cu.gtl, FlightBread-F_Mask.gts, FlightBread-F_Paste.gtp]
2023-03-13 updated Asoftware with gps and imu, tested on FlightBread, imu works but need antenna for GPS
2024-12-01 updated archive
    [FlightBread.kicad_pcb, FlightBread.kicad_sch, FlightBread_0.1.step]
