ControlSoup/ContraHopper/Archive/Documentation/Figures/FlightBreadv0.1.jpeg

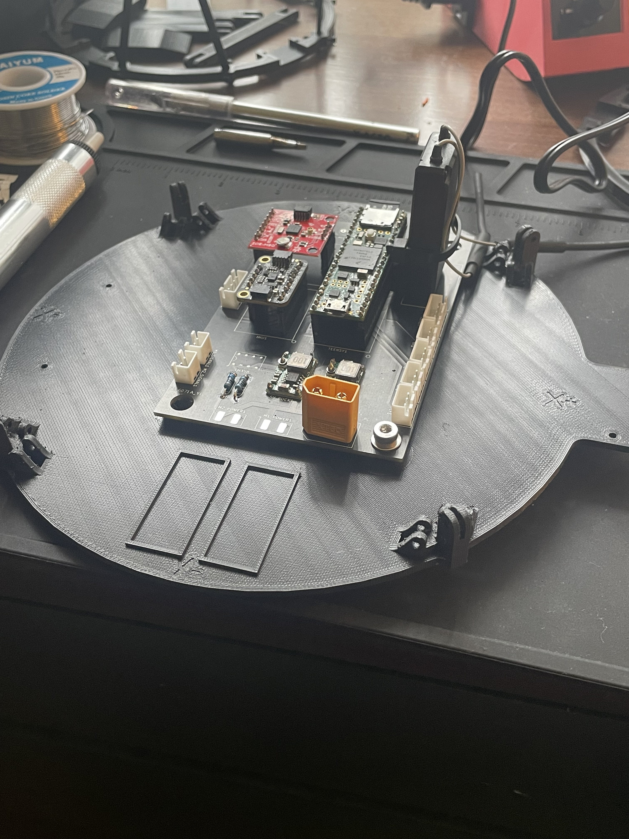
[picture p2: Documentation/Figures/FlightBreadv0.1.jpeg]
Archive/Documentation/Figures/FlightBreadv0.1.jpeg
